Flacarica/DST-2/KiCAD files/DST-2.kicad_pcb

## KiCad design KiCAD files/DST-2.kicad_pcb (2026-10-13)

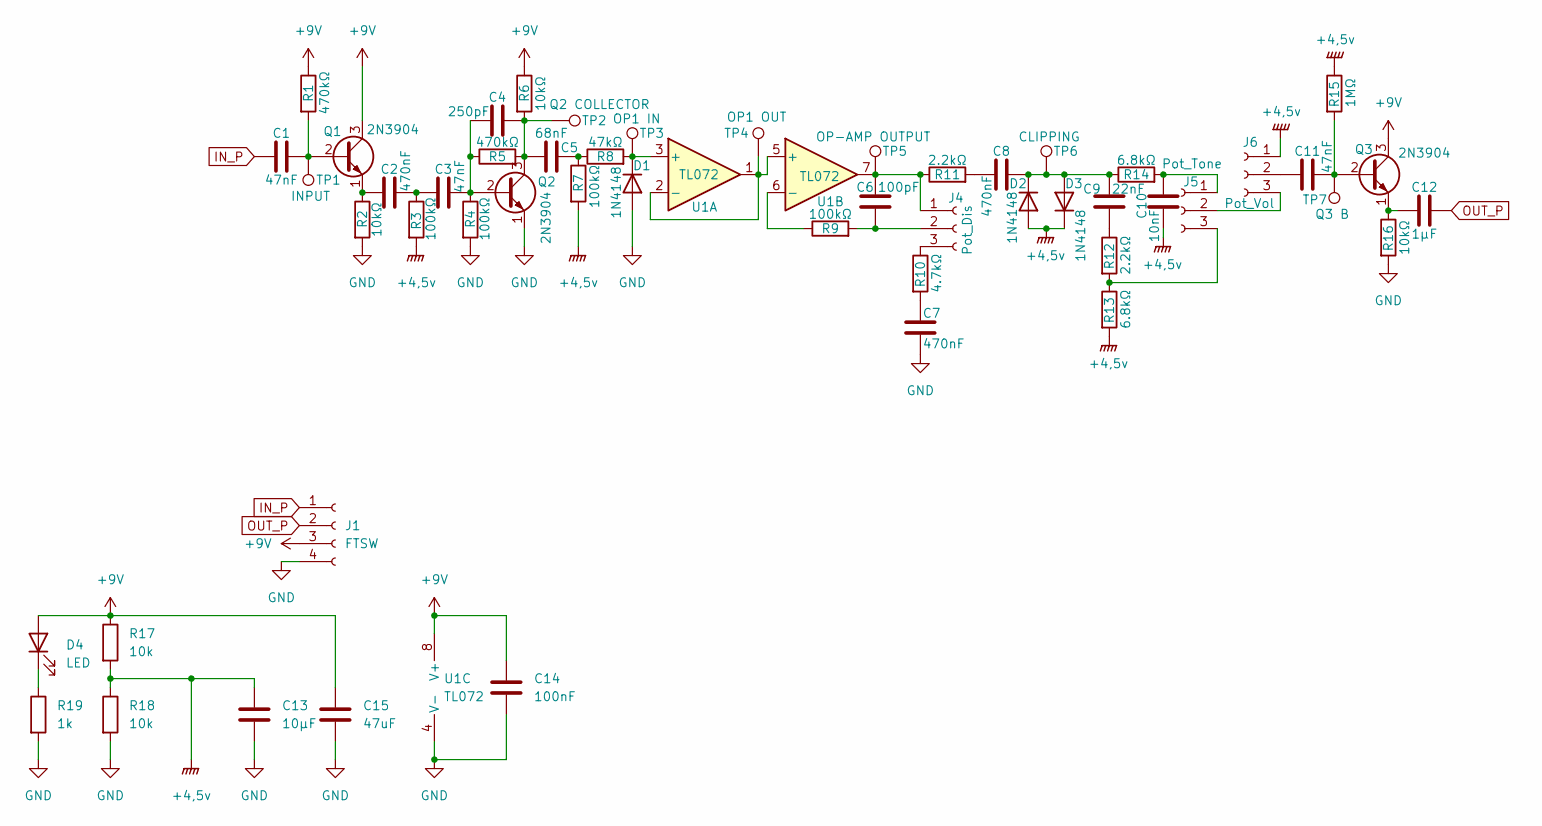
[picture p1: schematic DST-2.kicad_sch, DST - 2 Distortion pedal]

Parts:
C1, C3, C11: 47nF; C_0603_1608Metric_Pad1.08x0.95mm_HandSolder
C2, C7, C8: 470nF; C_0603_1608Metric_Pad1.08x0.95mm_HandSolder
C4: 250pF; C_0603_1608Metric_Pad1.08x0.95mm_HandSolder
C5: 68nF; C_0603_1608Metric_Pad1.08x0.95mm_HandSolder
C6: 100pF; C_0603_1608Metric_Pad1.08x0.95mm_HandSolder
C9: 22nF; C_0603_1608Metric_Pad1.08x0.95mm_HandSolder
C10: 10nF; C_0603_1608Metric_Pad1.08x0.95mm_HandSolder
C12: 1µF; C_0603_1608Metric_Pad1.08x0.95mm_HandSolder
C13: 10µF; C_Radial_D5.0mm_H11.0mm_P2.00mm
C14: 100nF; C_0603_1608Metric_Pad1.08x0.95mm_HandSolder
C15: 47uF; C_Radial_D5.0mm_H11.0mm_P2.00mm
D1, D2, D3: 1N4148; D_SOD-323F
D4: LED; LED_D5.0mm
J1: FTSW; PinHeader_1x04_P2.54mm_Vertical
J4: Pot_Dis; PinHeader_1x03_P2.54mm_Vertical
J5: Pot_Tone; PinHeader_1x03_P2.54mm_Vertical
J6: Pot_Vol; PinHeader_1x03_P2.54mm_Vertical
Q1, Q2, Q3: 2N3904; TSOT-23_HandSoldering
R1, R5: 470kΩ; R_0603_1608Metric_Pad0.98x0.95mm_HandSolder
R2, R6, R16: 10kΩ; R_0603_1608Metric_Pad0.98x0.95mm_HandSolder
R3, R4, R7, R9: 100kΩ; R_0603_1608Metric_Pad0.98x0.95mm_HandSolder
R8: 47kΩ; R_0603_1608Metric_Pad0.98x0.95mm_HandSolder
R10: 4.7kΩ; R_0603_1608Metric_Pad0.98x0.95mm_HandSolder
R11, R12: 2.2kΩ; R_0603_1608Metric_Pad0.98x0.95mm_HandSolder
R13, R14: 6.8kΩ; R_0603_1608Metric_Pad0.98x0.95mm_HandSolder
R15: 1MΩ; R_0603_1608Metric_Pad0.98x0.95mm_HandSolder
R17, R18: 10k; R_0603_1608Metric_Pad0.98x0.95mm_HandSolder
R19: 1k; R_0603_1608Metric_Pad0.98x0.95mm_HandSolder
TP1: INPUT; TestPoint_Pad_D1.0mm
TP2: Q2 COLLECTOR; TestPoint_Pad_D1.0mm
TP3: OP1 IN; TestPoint_Pad_D1.0mm
TP4: OP1 OUT; TestPoint_Pad_D1.0mm
TP5: OP-AMP OUTPUT; TestPoint_Pad_D1.0mm
TP6: CLIPPING; TestPoint_Pad_D1.0mm
TP7: Q3 B; TestPoint_Pad_D1.0mm
U1: TL072; SOIC-8_5.3x5.3mm_P1.27mm

Connections:
+4,5v: C10.1, C13.1, D2.2 (A), D3.1 (K), J6.1, R3.2, R7.2, R13.2, R15.1, R17.2, R18.1
+9V: C14.1, C15.1, D4.2 (A), J1.3, Q1.3 (C), Q3.3 (C), R1.1, R6.1, R17.1, U1.8 (V+)
GND: C7.2, C13.2, C14.2, C15.2, D1.2 (A), J1.4, Q2.1 (E), R2.2, R4.2, R16.2, R18.2, R19.2, U1.4 (V-)
IN_P: C1.1, J1.1
unnamed: C2.2, C3.1, R3.1
unnamed: C5.2, R7.1, R8.1
unnamed: C7.1, R10.2
unnamed: C8.1, R11.2
unnamed: C9.2, R12.1
unnamed: D1.1 (K), R8.2, TP3.1 (1_1), U1.3 (+)
unnamed: C8.2, C9.1, D2.1 (K), D3.2 (A), R14.1, TP6.1 (1_1)
unnamed: D4.1 (K), R19.1
unnamed: C6.1, J4.1, R11.1, TP5.1 (1_1), U1.7
unnamed: C6.2, J4.2, R9.2
unnamed: J4.3, R10.1
unnamed: C10.2, J5.1, R14.2
unnamed: J5.2, J6.3
unnamed: J5.3, R12.2, R13.1
unnamed: C11.1, J6.2
unnamed: C1.2, Q1.2 (B), R1.2, TP1.1 (1_1)
unnamed: C2.1, Q1.1 (E), R2.1
unnamed: C3.2, C4.1, Q2.2 (B), R4.1, R5.1
unnamed: C4.2, C5.1, Q2.3 (C), R5.2, R6.2, TP2.1 (1_1)
unnamed: C11.2, Q3.2 (B), R15.2, TP7.1 (1_1)
unnamed: C12.1, Q3.1 (E), R16.1
unnamed: TP4.1 (1_1), U1.1, U1.2 (-), U1.5 (+)
unnamed: R9.1, U1.6 (-)
OUT_P: C12.2, J1.2

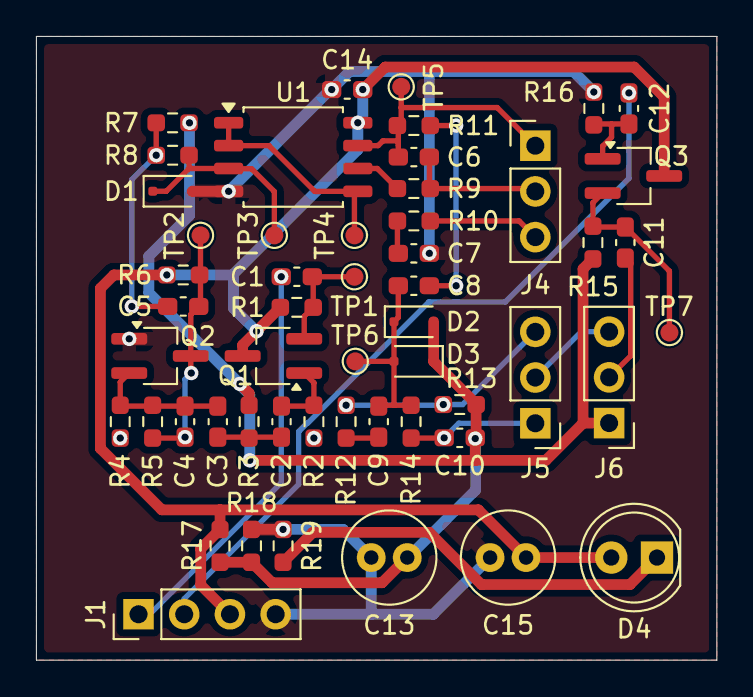
[picture p2: board DST-2.kicad_pcb from above]

Board: 2 copper layers, 37.8 x 34.7 mm, 53 parts (0 on the bottom side), 28 nets.
