Flacarica/DST-2/(commit log)

2026-10-13 Modified schematic and started a new PCB design
2026-10-13 Finished PCB design
